tdene/OSU_ECEN5313_S2022_template/(commit log)

2022-04-19 Initial commit with LDO example included
    [Analyses_Template.sch, LDO.sch, current_mirror.sch, test_current_mirror.sch]
2022-04-19 Updated analyses and README
    [Analyses_Template.sch]
2022-04-19 Move template files to template folder
    [Analyses_Template.sch, LDO.sch, current_mirror.sch, test_current_mirror.sch]
2022-04-21 Updated Analyses_Template.sch
    [Analyses_Template.sch]
2022-04-21 Added to Analyses_Template.sch
    [Analyses_Template.sch]
2022-04-23 Move Analyses_Template.sch to template folder
    [Analyses_Template.sch]
2022-04-23 Initial commit
    Copy files over from template folder
    [Analyses_Template.sch, LDO.sch, current_mirror.sch, test_current_mirror.sch]
2022-04-23 Initial buck converter
    [Buck.sch, LDO.sch, current_mirror.sch, test_Buck.sch, test_current_mirror.sch]
2022-04-23 Add ESR and DCR; change freq to 1MHz
    [Buck.sch, test_Buck.sch]
2022-04-23 Added deadtime
    [Buck.sch, test_Buck.sch]
2022-04-24 Add drive train; 1.8V Vout
    [Buck.sch, drive_train.sch]
2022-04-24 Changed VDD to VDDH.
    [Buck.sch, drive_train.sch, test_Buck.sch]
2022-04-24 Created untested deadtime generator.
    [deadtime.sch]
2022-04-24 Placed device names in code blocks
2022-04-24 Fix absolute path issue in deadtime.sch
    [deadtime.sch]
2022-04-24 Non-working HV digital setup
    [Buck.sch, deadtime.sch, test_Buck.sch]
2022-04-24 Add inverter and NAND2 standard cells
    [deadtime.sch, inv.sch, nand2.sch, test_Buck.sch]
2022-04-24 It worksgit add *sch!
    [deadtime.sch, inv.sch]
2022-04-24 1.82V Vout
    [Buck.sch, deadtime.sch]
2022-04-24 1.8V Vout
    [Buck.sch, deadtime.sch, drive_train.sch]
2022-04-24 88.4% efficiency
    [Buck.sch, test_Buck.sch]
2022-04-24 Working power efficiency number
    [test_Buck.sch]
2022-04-25 Added schematics.
2022-04-25 Updated Analyses_Template
    [Analyses_Template.sch]
2022-04-25 Pushing PA scripts
    [Buck.sch, test_Buck.sch]
2022-04-25 Added two diagrams showing the converter stop working at low currents
